thomasfla/pico_pmsm_mpq6541/README.md

# pico_pmsm_mpq6541
Test board to drive PMSM motor with integrated solution mpq6541 motor driver + AD7686 ADC for current sensing. 40V 8A
