thomasfla/pico_pmsm_mpq6541/(commit log)

2025-07-31 add design files
    [pico_pmsm_laas.kicad_pcb, pico_pmsm_laas.kicad_sch]
2025-07-31 add quadrature encoder input, refine the design, change THVD tranceiver footprint, add label for connectors
    [pico_pmsm_laas.kicad_pcb, pico_pmsm_laas.kicad_sch]
2025-07-31 update pcb values
    [pico_pmsm_laas.kicad_pcb]
2025-08-01 add some reference, change 0603 cap for 0402
    [pico_pmsm_laas.kicad_pcb, pico_pmsm_laas.kicad_sch]
2025-08-01 add some refs
    [pico_pmsm_laas.kicad_sch]
